cforcomputer/acoustic-replicator/docs/img/tb25_routed_back.png

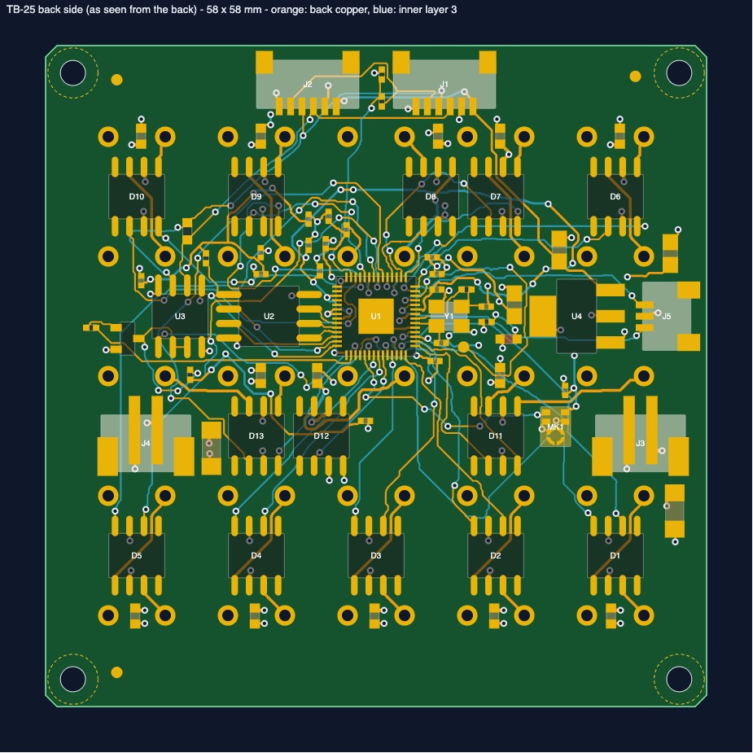
docs/img/tb25_routed_back.png
