cforcomputer/acoustic-replicator/hardware/pcb/TB-25_BOM_JLCPCB.csv

Comment | Designator | Footprint | LCSC Part #
1 uF 25 V X5R 0402 | C10,C9 | C0402 | C52923
15 pF 50 V C0G 0402 | C11,C12 | C0402 | C1548
10 uF 25 V X5R 0805 | C14,C15,C20 | C0805 | C15850
100 nF 16 V X7R 0402 | C18,C19,C1,C2,C3,C4,C5,C6,C7,C8,C13,C16,C17 | C0402 | C1525
10 uF 50 V X5R 1206 | CB1,CB2 | C1206 | C13585
1 uF 50 V X5R 0603 | CD1,CD2,CD3,CD4,CD5,CD6,CD7,CD8,CD9,CD10,CD11,CD12,CD13 | C0603 | C15849
IX4427NTR dual 1.5 A driver, 4.5-30 V | D1,D2,D3,D4,D5,D6,D7,D8,D9,D10,D11,D12,D13 | SOIC-8_L4.9-W3.9-P1.27-LS6.0-BL | C171845
SM06B-SRSS-TB | J1,J2 | CONN-SMD_SM06B-SRSS-TB-LF-SN | C160405
B2B-PH-SM4-TB | J3,J4 | CONN-SMD_B2B-PH-SM4-TB-LF-SN | C160352
SM03B-SRSS-TB | J5 | CONN-SMD_SM03B-SRSS-TB-LF-SN-P | C160403
red LED 0603 | LD1 | LED-SMD_L1.6-W0.8-R-RD | C2286
SPH0641LU4H-1 ultrasonic PDM microphone | MK1 | MIC-SMD_5P_L3.5-W2.7-P0.82_SPH0641LU4H-1 | C2879853
MMBT3904 | Q1 | SOT-23-3_L2.9-W1.3-P1.90-LS2.4-BR | C20526
1 k 1 % 0402 | R1,R6 | R0402 | C11702
10 k 1 % 0402 | R2,R8,R7,R5 | R0402 | C25744
100 R 1 % 0402 | R4 | R0402 | C25076
RP2040 | U1 | LQFN-56_L7.0-W7.0-P0.4-EP | C2040
W25Q16JVSSIQ, 16 Mbit QSPI flash | U2 | SOIC-8_L5.3-W5.3-P1.27-LS8.0-BL | C131025
SP3485EN-L/TR | U3 | SOIC-8_L5.0-W4.0-P1.27-LS6.0-BL | C8963
AMS1117-3.3 | U4 | SOT-223-3_L6.5-W3.4-P2.30-LS7.0-BR | C6186
ABM8-272-T3, 12 MHz, CL 10 pF (the crystal Raspberry Pi specifies) | Y1 | CRYSTAL-SMD_4P-L3.2-W2.5-BL | C20625731
