cforcomputer/acoustic-replicator/hardware/print/chuck.stl

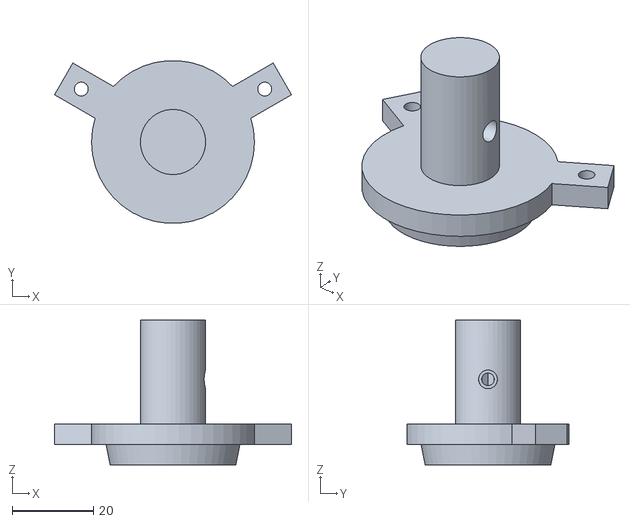
[picture p12: CAD file, 2026-11-11]
hardware/print/chuck.stl
58.2 x 39.9 x 35.5
