cforcomputer/acoustic-replicator/hardware/replicator_mk2.step

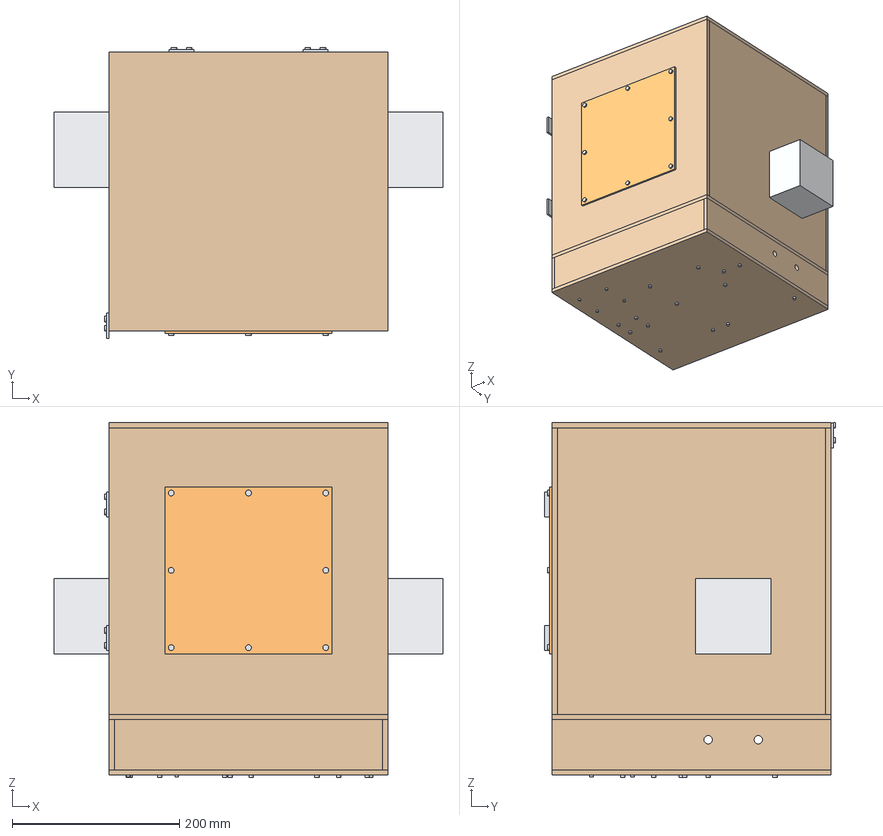
[picture p13: CAD file, 2026-11-11]
hardware/replicator_mk2.step
465.5 x 347.7 x 425.2 mm
TB-25 board sq00
TB-25 board sq01
TB-25 board sq02
TB-25 board sq03
TB-25 board sq04
TB-25 board sq05
TB-25 board sq06
TB-25 board sq07
TB-25 board sq08
TB-25 board sq09
TB-25 board sq10
TB-25 board sq11
TB-25 board sq12
TB-25 board sq13
TB-25 board sq14
TB-25 board sq15
TB-25 board sq16
TB-25 board sq17
M2x8 screw x 72
M2 screw head x 72
M3 x 6.7 mm knurled thumb screw
M3 x 6.7 mm knurled thumb screw (head)
M3 heat-set insert (brass) x 17
M3 x 12 mm knurled thumb screw x 2
M3 x 12 mm knurled thumb screw (head) x 2
M4 x 20 mm socket-head screw x 3
M4 x 20 mm socket-head screw (head) x 3
M4 heat-set insert (brass) x 3
M5 x 20 mm socket-head screw x 3
M5 x 20 mm socket-head screw (head) x 3
M5 heat-set insert (brass) x 3
M3 x 16 mm socket-head screw x 6
M3 x 16 mm socket-head screw (head) x 6
M3 x 8 mm knurled thumb screw
M3 x 8 mm knurled thumb screw (head)
M2.5 x 8 mm socket-head screw x 16
M2.5 x 8 mm socket-head screw (head) x 16
M2.5 heat-set insert (brass) x 10
M3 x 14 mm socket-head screw x 2
M3 x 14 mm socket-head screw (head) x 2
M3 x 6 mm socket-head screw x 22
M3 x 6 mm socket-head screw (head) x 22
M2 x 5 mm socket-head screw x 12
M2 x 5 mm socket-head screw (head) x 12
M3 x 5 mm socket-head screw x 10
M3 x 5 mm socket-head screw (head) x 10
M3 x 12 mm socket-head screw x 6
M3 x 12 mm socket-head screw (head) x 6
M2.5 x 6 mm socket-head screw x 2
M2.5 x 6 mm socket-head screw (head) x 2
3.5 mm x 9.5 mm wood screw, pan head x 8
3.5 mm x 9.5 mm wood screw, pan head (head) x 8
3.5 mm x 9 mm wood screw, pan head x 8
3.5 mm x 9 mm wood screw, pan head (head) x 8
3.5 mm x 16 mm wood screw, pan head x 8
3.5 mm x 16 mm wood screw, pan head (head) x 8
M2 x 10 mm socket-head screw x 4
M2 x 10 mm socket-head screw (head) x 4
M4 x 16 mm socket-head screw x 8
M4 x 16 mm socket-head screw (head) x 8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
