cforcomputer/acoustic-replicator/hardware/print/stand_leg0.stl

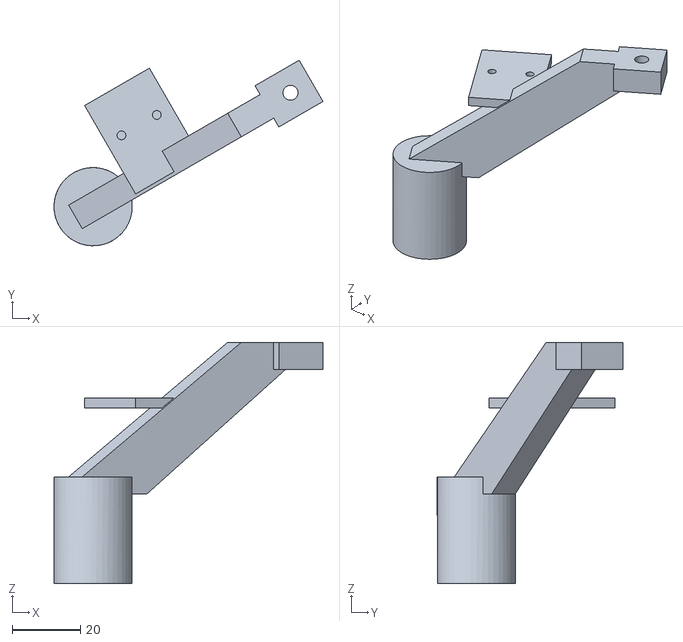
[picture p14: CAD file, 2026-11-11]
hardware/print/stand_leg0.stl
79.1 x 54.6 x 70.9
