cforcomputer/acoustic-replicator/hardware/print/frame_mid.stl

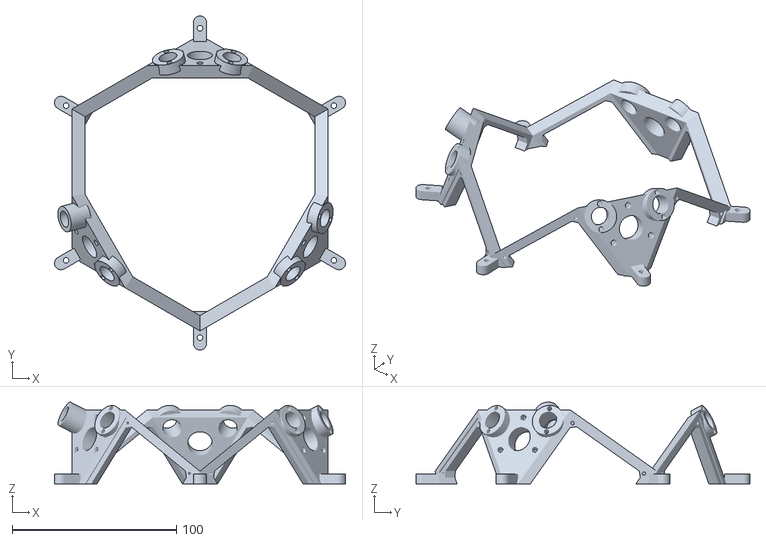
[picture p15: CAD file, 2026-11-11]
hardware/print/frame_mid.stl
177.4 x 203.6 x 50.0
