cforcomputer/acoustic-replicator/hardware/print/frame_lower.stl

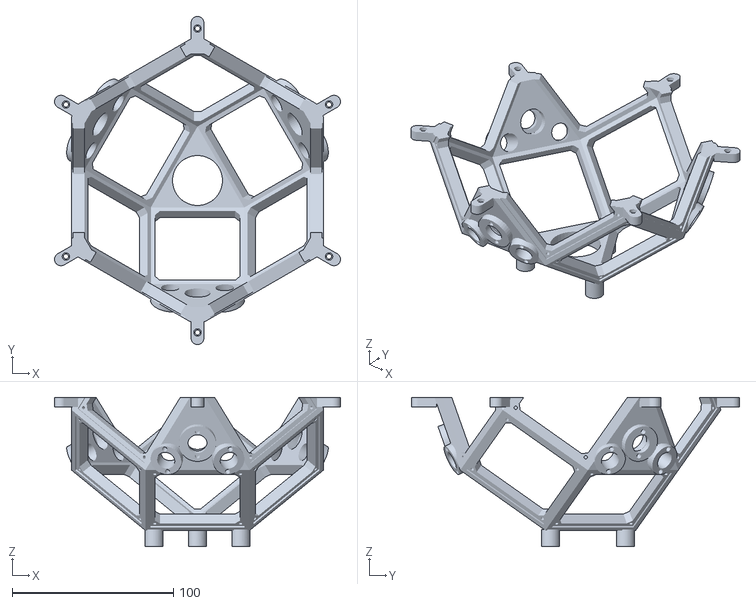
[picture p16: CAD file, 2026-11-11]
hardware/print/frame_lower.stl
177.4 x 203.6 x 92.5
