cforcomputer/acoustic-replicator/hardware/print/dock.stl

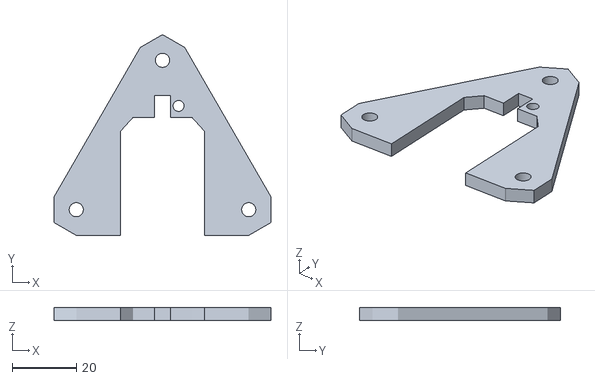
[picture p17: CAD file, 2026-11-11]
hardware/print/dock.stl
67.5 x 62.5 x 4.00
