cforcomputer/acoustic-replicator/hardware/print/pod1.stl

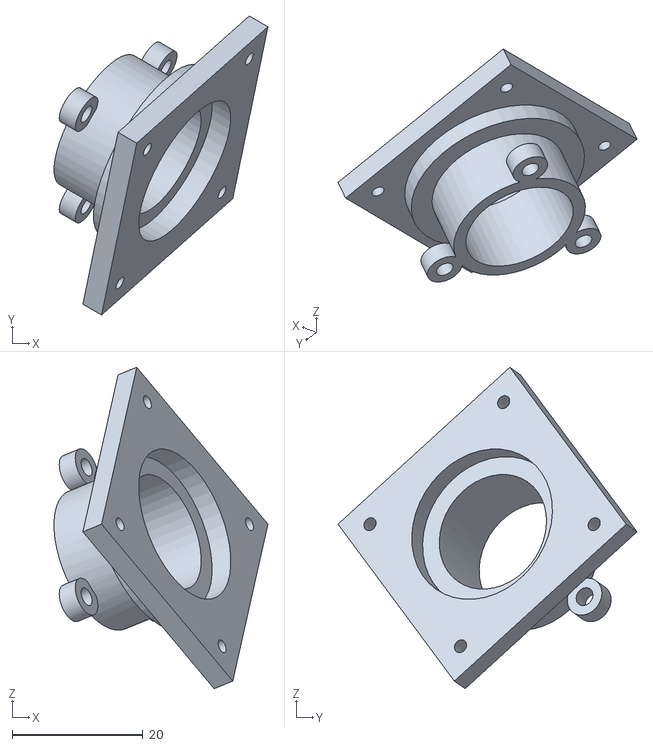
[picture p18: CAD file, 2026-11-11]
hardware/print/pod1.stl
32.7 x 45.7 x 49.2
