cforcomputer/acoustic-replicator/hardware/print/jet_body.stl

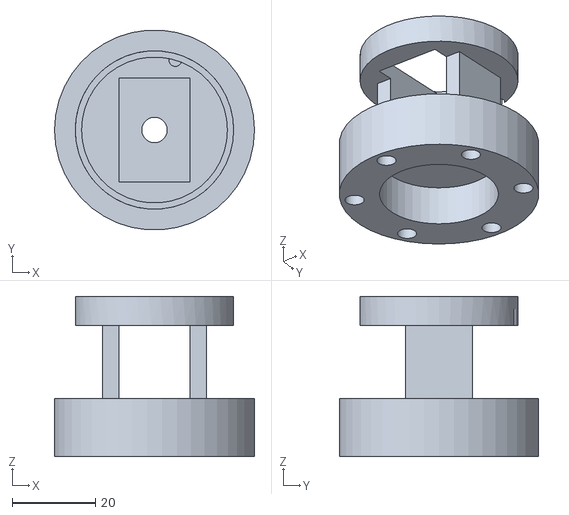
[picture p19: CAD file, 2026-11-11]
hardware/print/jet_body.stl
48.0 x 47.9 x 38.5
