cforcomputer/acoustic-replicator/hardware/print/jet_clamp.stl

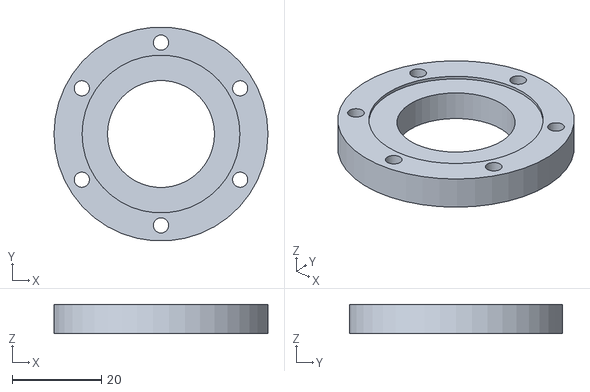
[picture p21: CAD file, 2026-11-11]
hardware/print/jet_clamp.stl
48.0 x 47.9 x 6.60
