cforcomputer/acoustic-replicator/hardware/print/pod2.stl

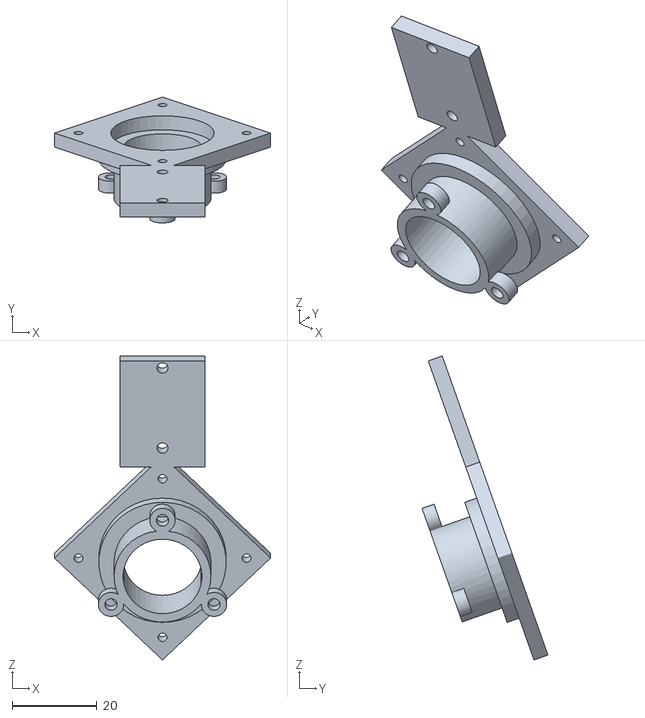
[picture p22: CAD file, 2026-11-11]
hardware/print/pod2.stl
50.9 x 29.7 x 71.6
