cforcomputer/acoustic-replicator/hardware/print/gate_bracket.stl

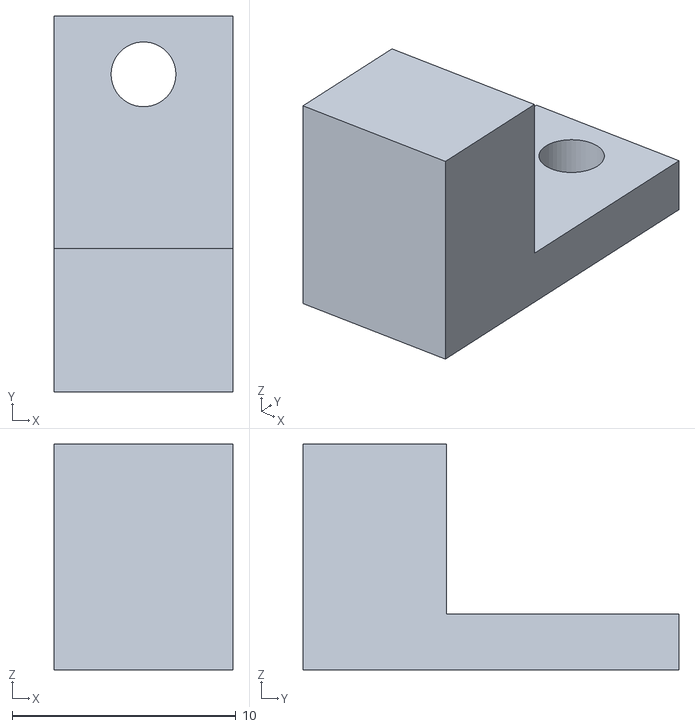
[picture p23: CAD file, 2026-11-11]
hardware/print/gate_bracket.stl
8.00 x 16.8 x 10.1
