cforcomputer/acoustic-replicator/hardware/print/res_clamp.stl

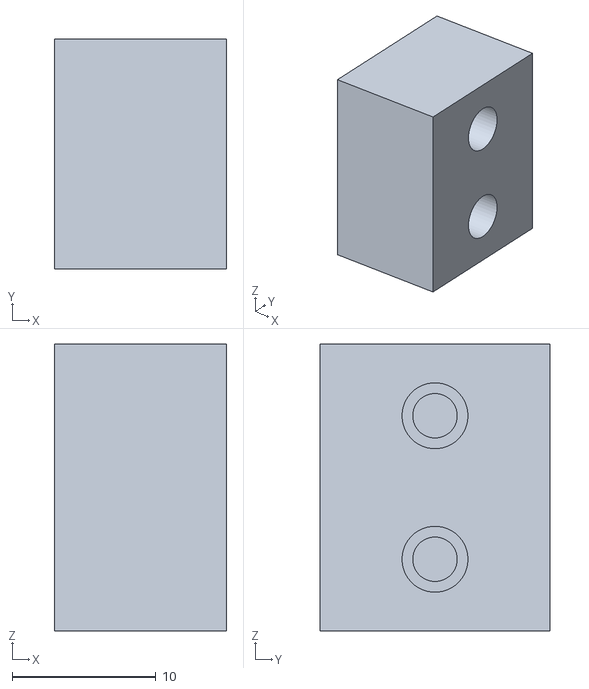
[picture p24: CAD file, 2026-11-11]
hardware/print/res_clamp.stl
12.0 x 16.0 x 20.0
