cforcomputer/acoustic-replicator/hardware/print/stand_leg2.stl

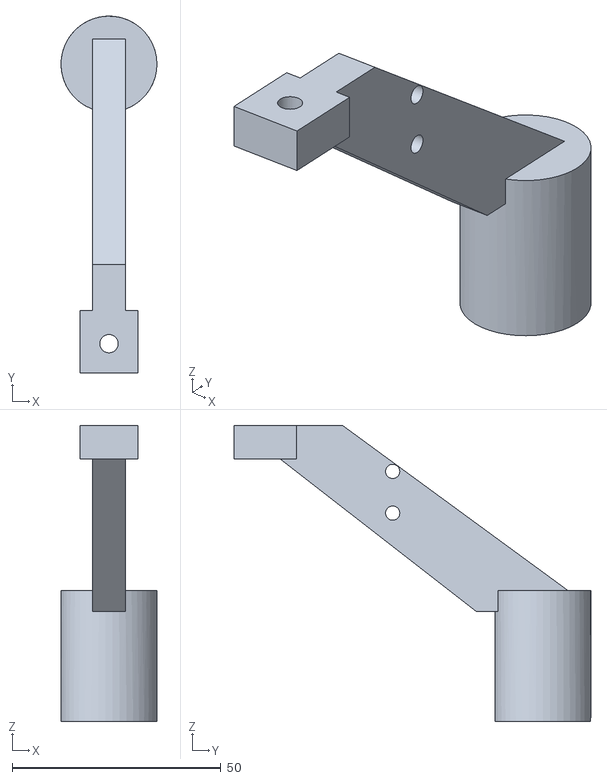
[picture p25: CAD file, 2026-11-11]
hardware/print/stand_leg2.stl
23.0 x 85.5 x 70.9
