cforcomputer/acoustic-replicator/hardware/print/frame_cap.stl

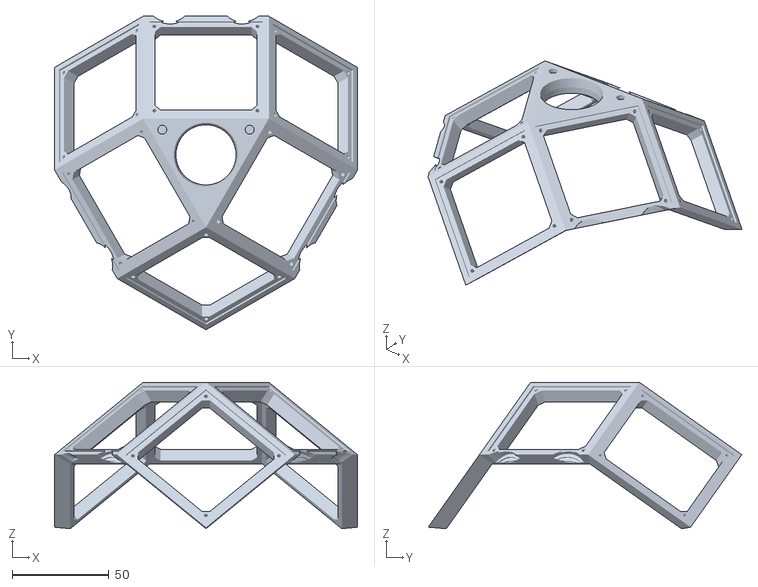
[picture p26: CAD file, 2026-11-11]
hardware/print/frame_cap.stl
156.2 x 161.7 x 75.5
