cforcomputer/acoustic-replicator/(list of files, cad)

Other CAD files:
hardware/print/pod0.stl
