cforcomputer/acoustic-replicator/(commit log)

2026-11-11 Acoustic-levitation resin printer: simulation, hardware design and routed board
    [TB-25-B_Cu.gbl, TB-25-B_Mask.gbs, TB-25-B_Paste.gbp, TB-25-B_Silkscreen.gbo, TB-25-Edge_Cuts.gm1, TB-25-F_Cu.gtl, TB-25-F_Mask.gts, TB-25-F_Silkscreen.gto]
2026-11-11 README: animated in-camera view of the print
